ChikaraWakaura/i2sDinDisp/(threads)

Thread 1 (2022-07-22):

Can you provide a complete wiring diagram of the circuit board?

sevenberyl, 2022-07-22:
Great example！
My pcm1808 doesn't work and I want to know how to connect esp32。

Can you provide a complete wiring diagram of the circuit board?

Thank you！

ChikaraWakaura, 2022-07-22:
hello. Unfortunately, there is no circuit that shows the whole thing. The connection with the ESP32 is as shown in "Connecting the PCM1808 board with the esp32".

Closed 2023-03-13.
